willdickson/teensy3x_solenoid_driver/README.md

# teensy3x_solenoid_driver 
A teensy3x expansion board for driving solenoid valves.

# License: 
Creative Commons Attribution 4.0 International CC BY 4.0
