willdickson/teensy3x_solenoid_driver/500mA_7Chan/fab_files/BOM_JLCPCB.xlsx

Comment | Designator | Footprint | LCSC Part #（optional） | Qty
10uF ceramic capacitor | C1 | 805 | C440198 | 1
TBD62003A transistor array driver | U2 | SOP-16_4.4x10.0x1.27P | C114084 | 1
LED, Blue 465~475nm | D1,D2,D3,D4,D5,D6,D7 | 603 | C72041 | 7
120 Ohm resistor 1% 1/10W | R1,R2,R3,R4,R5,R6,R7 | 603 | C22787 | 7
