willdickson/teensy3x_solenoid_driver/500mA_7Chan/teensy3x_solenoid_driver.pdf

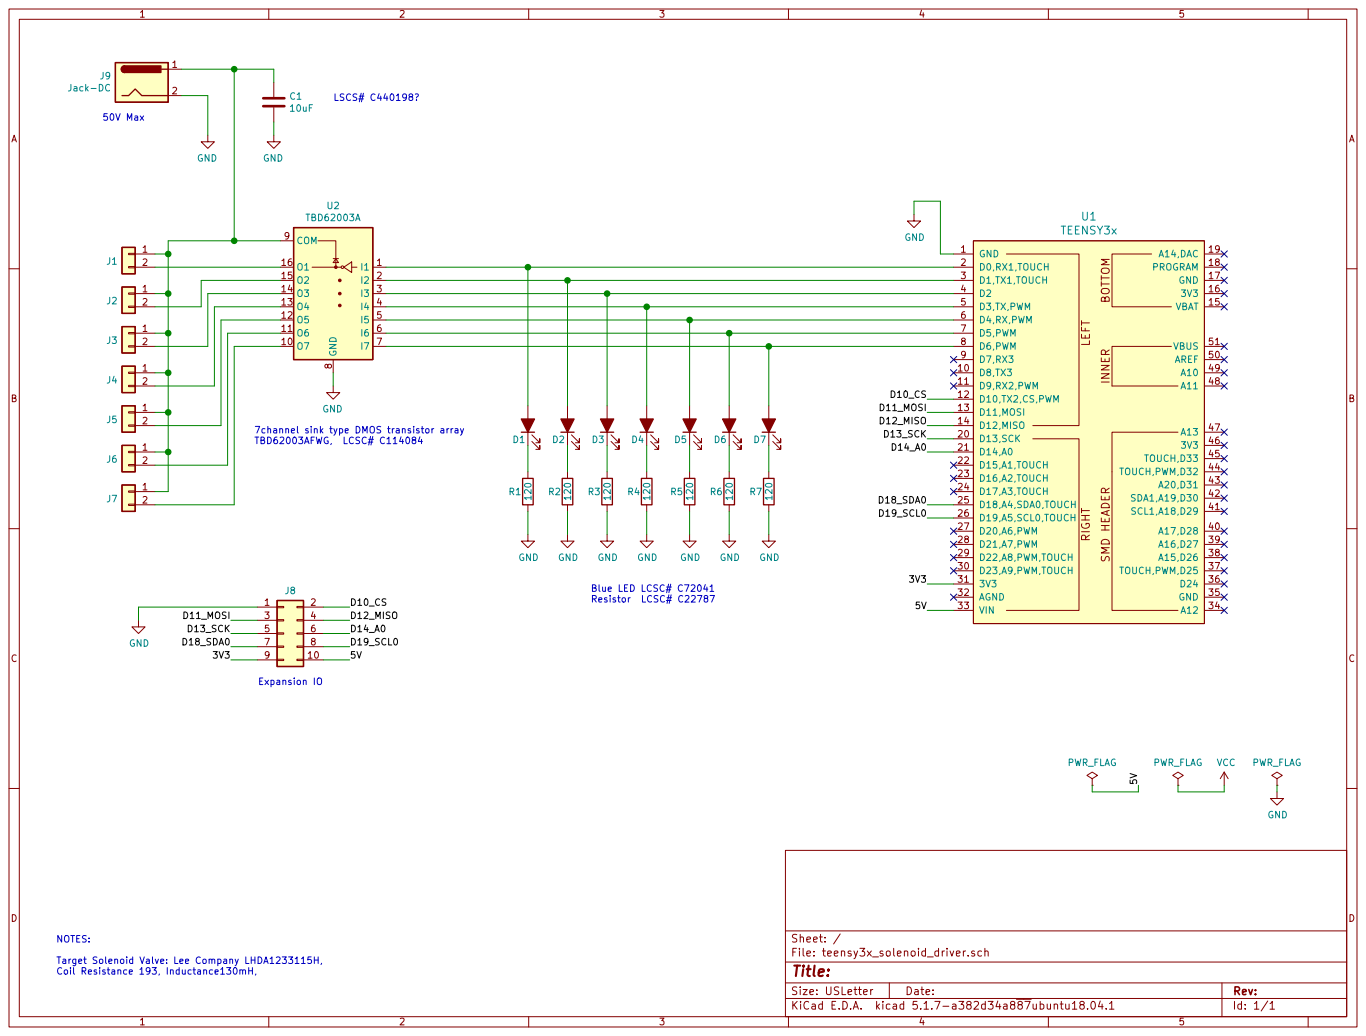
[picture p1: page 1]

LSCS# C440198 7channel sink type DMOS transistor array TBD62003AFWG, LCSC# C114084

Blue LED LCSC# C72041 Resistor LCSC# C22787 Expansion IO

NOTES: Target Solenoid Valve: Lee Company LHDA1233115H, Coil Resistance 193, Inductance130mH,
