willdickson/teensy3x_solenoid_driver/8A_8Chan/teensy3x_solenoid_driver.pdf

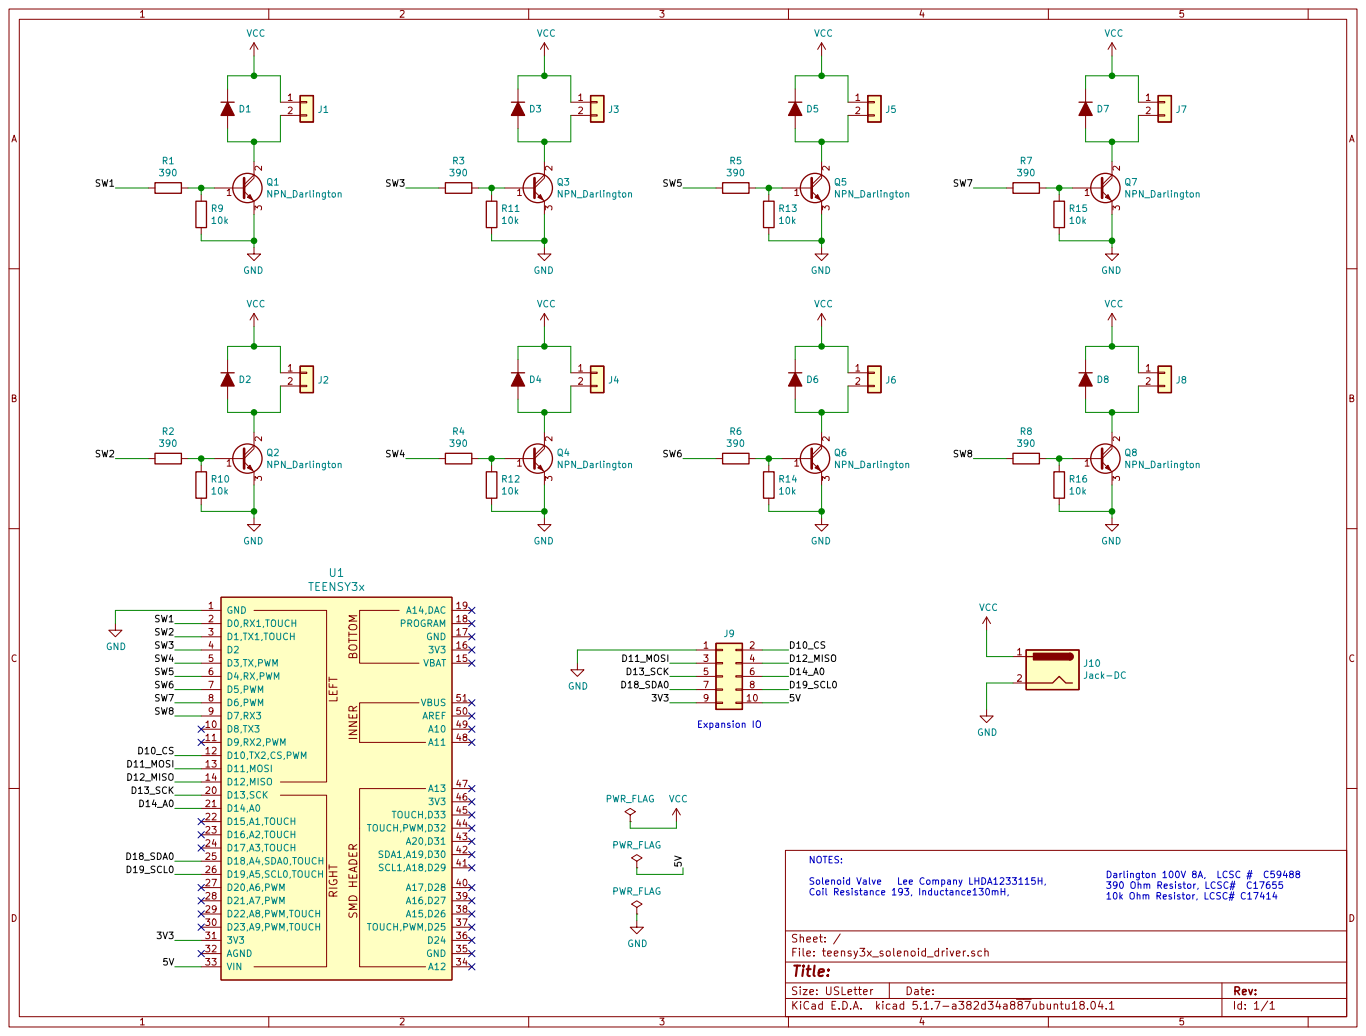
[picture p2: page 1]

2 3 Q2NPN_Darlington PWR_FLAG BOTTOM INNER LEFT RIGHT SMD HEADER
