willdickson/teensy3x_solenoid_driver/(list of files, drawings)

Other design files:
500mA_7Chan/teensy3x_solenoid_driver.dsn
