willdickson/teensy3x_solenoid_driver/500mA_7Chan/teensy3x_solenoid_driver.kicad_pcb

## KiCad design 500mA_7Chan/teensy3x_solenoid_driver.kicad_pcb (2021-02-25)

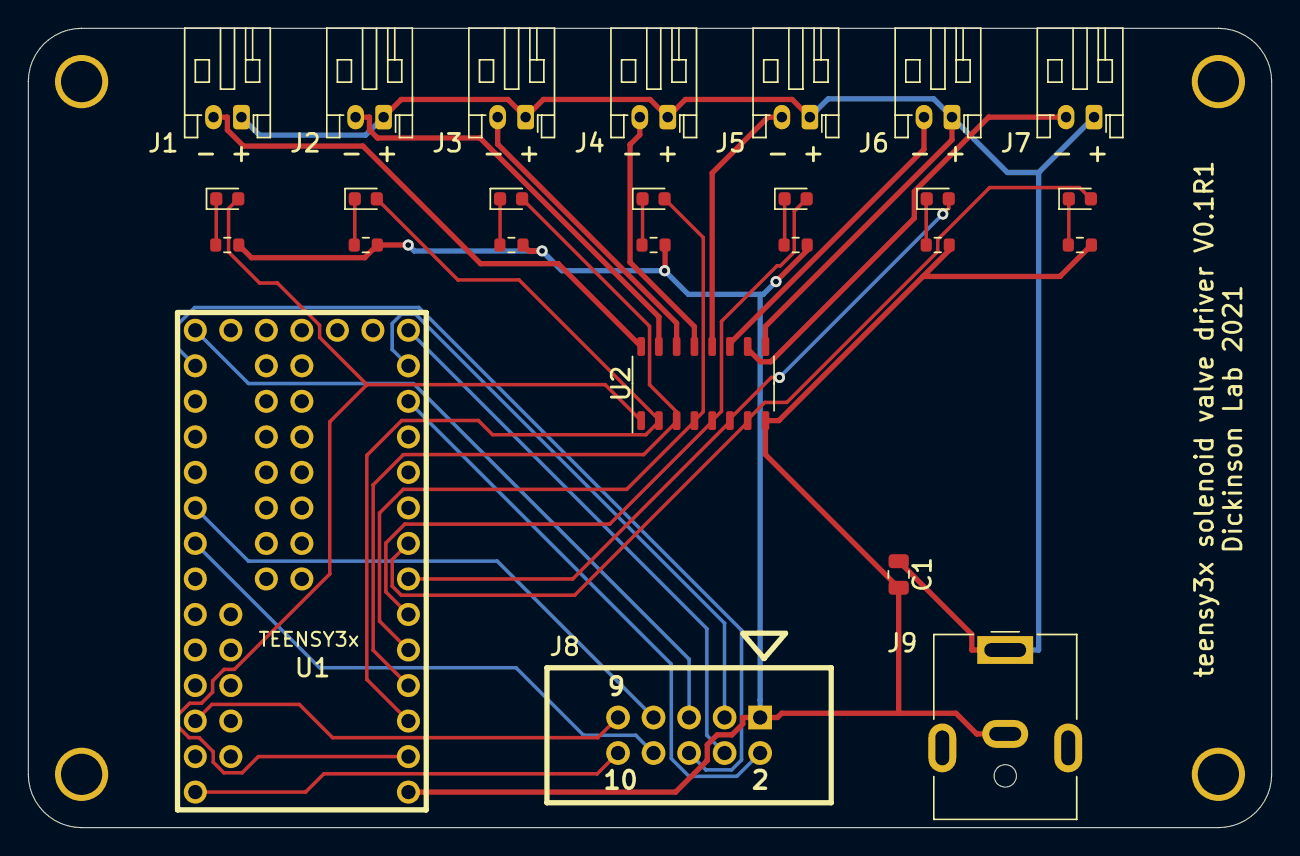
[picture p3: board teensy3x_solenoid_driver.kicad_pcb from above]

Board: 2 copper layers, 88.9 x 57.2 mm, 30 parts (0 on the bottom side), 32 nets.

Parts:
C1: 10uF; C_0805_2012Metric
D1, D2, D3, D4, D5, D6, D7: LED_ALT; LED_0603_1608Metric
J1, J2, J3, J4, J5, J6, J7: Conn_01x02; JST_PH_S2B-PH-K_1x02_P2.00mm_Horizontal
J8: Conn_02x05_Odd_Even; 5X2_SHRD_HEADER
J9: Jack-DC; BarrelJack_CUI_PJ-063AH_Horizontal
M1, M2, M3, M4: VAL**; 4-40
R1, R2, R3, R4, R5, R6, R7: 330; R_0603_1608Metric
U1: TEENSY3x; TEENSY3X
U2: TBD62003A; SOP-16_3.9x9.9mm_P1.27mm

Connections:
/3V3: J8.9, U1.31
/5V: J8.10, U1.33
/D10_CS: J8.2, U1.12
/D11_MOSI: J8.3, U1.13
/D12_MISO: J8.4, U1.14
/D13_SCK: J8.5, U1.20
/D14_A0: J8.6, U1.21
/D18_SDA0: J8.7, U1.25
/D19_SCL0: J8.8, U1.26
GND: C1.2, J8.1, J9.2, R1.2, R2.2, R3.2, R4.2, R5.2, R6.2, R7.2, U1.1, U2.8
unnamed: C1.1, J1.1, J2.1, J3.1, J4.1, J5.1, J6.1, J7.1, J9.1, U2.9
unnamed: D1.1, R1.1
unnamed: D1.2, U1.2, U2.1
unnamed: D2.1, R2.1
unnamed: D2.2, U1.3, U2.2
unnamed: D3.1, R3.1
unnamed: D3.2, U1.4, U2.3
unnamed: D4.1, R4.1
unnamed: D4.2, U1.5, U2.4
unnamed: D5.1, R5.1
unnamed: D5.2, U1.6, U2.5
unnamed: D6.1, R6.1
unnamed: D6.2, U1.7, U2.6
unnamed: D7.1, R7.1
unnamed: D7.2, U1.8, U2.7
unnamed: J1.2, U2.16
unnamed: J2.2, U2.15
unnamed: J3.2, U2.14
unnamed: J4.2, U2.13
unnamed: J5.2, U2.12
unnamed: J6.2, U2.11
unnamed: J7.2, U2.10
