willdickson/teensy3x_solenoid_driver/(commit log)

2021-02-23 Project creation.
    [teensy3x_solenoid_driver.kicad_pcb, teensy3x_solenoid_driver.sch]
2021-02-23 Changed base resistor ... forgot about extra voltage drop due to darlington transistor.
    [teensy3x_solenoid_driver.sch]
2021-02-24 Added new 7 channel 500mA/channel design based on TBD62003A.
    [teensy3x_solenoid_driver.kicad_pcb, teensy3x_solenoid_driver.sch]
2021-02-24 Finished initial layout and routing for 500mA design.
    [teensy3x_solenoid_driver.dsn, teensy3x_solenoid_driver.sch]
2021-02-25 Added finished initial design of 7channel driver.
    [BOM_JLCPCB.xlsx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]
